Moltino/Moltino/README.md

<h1 align="center">Moltino icon</h1>
<div align="center"><I> Arduino controlled compact modular I/O module </div></I><br>
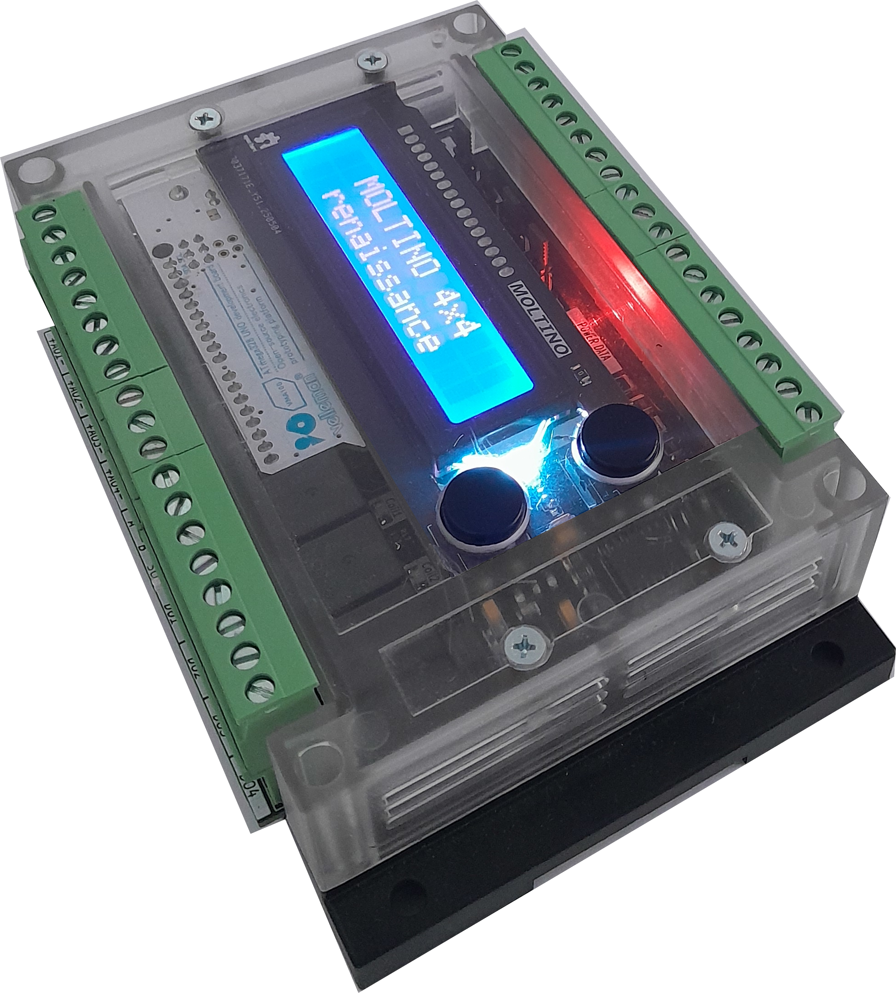
[picture p1: images/IMG_.png]
Moltino 4x4 renaissance

  
<p><b> MOLTINO </b> is a versatile family of modular input/output (I/O) devices designed for measurement, control, and monitoring in industrial, academic, and development environments.
It is a documented hardware platform with publicly available schematics to support firmware creation and system integration.
Users are encouraged to develop their own firmware and applications tailored to specific use cases.
The system is compatible with a wide range of Arduino Uno form factor controllers, including AVR, STM32, ESP32, RP2040, among others, offering flexibility and scalability for different performance needs. These platforms also enable the integration of additional features such as wireless communication (Wi-Fi, Bluetooth), real-time clock (RTC), external storage, or advanced processing capabilities, significantly expanding the development possibilities depending on the project.<br>
<b> MOLTINO </b> is committed to fostering openness and collaboration while ensuring commercial viability and product reliability.</p><hr>
<p><lh><u><b>Main features <b>MOLTINO</b> 4x4 renaissance:</b></u></lh>
<ul><li>4 0-10V/0-20mA analog inputs (16bit resolution)</li>
<li>4 multifunction smart digital inputs</li>
<li>4 0-10V/300mA analog outputs</li>
<li>4 relay outputs</li>
<li>Logic compatible with 5V and 3.3V</li>
<li>Integrated power supply</li>
<li>Integrated RS485 communication</li>
<li>Optional LCD screen</li>
<li>Modular design</li>
<li>Maximum protection</li></ul></p><hr>
<p><b>Flexible firmware development:</b></p>
<p><b> MOLTINO </b> allows anyone to develop their own firmware tailored to specific needs.
Thanks to its compatibility with standard Arduino Uno form factor boards, developers can easily use a wide range of controllers available on the market — including AVR, STM32, ESP32, and RP2040 — to create powerful and customized solutions.</p>
<p><b> Ready-to-Use Firmware:</b></p>
<p>Precompiled firmware versions are also available for download, eliminating the need for firmware development in many cases. These firmwares are personalizable and configurable, can be adapted to various use cases with minimal effort.</p>
