Moltino/Moltino/docs/hardware/portreference_rev7.pdf

## MOLTINO 4x4 renaissance – arduino port reference

Rev.7.
tmslab 2025-05-24
Arduino port | UNO R3 16bit AD
0 | RS485 RX
1 | RS485 TX
2 | RS485 DIR
3 | DI1
4 | DO1
5 | AO1 (PWM)
6 | AO2 (PWM)
7 | DO2
8 | DO3
9 | AO3 (PWM)
10 | AO4 (PWM)
11 | DI2
12 | DI3
13 | DATA LED
(A0) 14 | DI4
(A1) 15 | DO4
(A2) 16 | BUTTON1
(A3) 17 | BUTTON2
(A4) 18 | SDA
(A5) 19 | SCL
