Moltino/Moltino/docs/index.md

# Bienvenido a la documentación de MOLTINO
