Moltino/Moltino/docs/firmware/ES/Mapa_de_registros_Moltino_xxx_v16_ext.xlsx

MAPA DE REGISTROS MODBUS MOLTINO xxx
Ver.:16.2
Última revisión: 15.09.2025
tmslab
READ COILS Código de función: 01
Dirección del registro (dec) | Memoria de almacenamiento | Acción | Descripción | Valor por defecto | Disponibilidad
0 | VOLATILE | RW | Leer el estado de la salida digital 1 (boolean) |  | UNO R3,R4 | M4x4,M2x8
1 | VOLATILE | RW | Leer el estado de la salida digital 2 (boolean) |  | UNO R3,R4 | M4x4,M2x8
2 | VOLATILE | RW | Leer el estado de la salida digital 3 (boolean) |  | UNO R3,R4 | M4x4,M2x8
3 | VOLATILE | RW | Leer el estado de la salida digital 4 (boolean) |  | UNO R3,R4 | M4x4,M2x8
4 | VOLATILE | RW | Leer el estado de la salida digital 5 (boolean) |  | UNO R3,R4 | M2x8
5 | VOLATILE | RW | Leer el estado de la salida digital 6 (boolean) |  | UNO R3,R4 | M2x8
6 | VOLATILE | RW | Leer el estado de la salida digital 7 (boolean) |  | UNO R3,R4 | M2x8
7 | VOLATILE | RW | Leer el estado de la salida digital 8 (boolean) |  | UNO R3,R4 | M2x8
READ DISCRETE INPUTS Código de función: 02
Dirección del registro (dec) | Memoria de almacenamiento | Acción | Descripción |  | Disponibilidad
10000 | VOLATILE | RO | Leer el estado instantaneo de la entrada digital 1 (boolean) |  | UNO R3,R4 | M4x4,M2x8
10001 | VOLATILE | RO | Leer el estado instantaneo de la entrada digital 2 (boolean) |  | UNO R3,R4 | M4x4,M2x8
10002 | VOLATILE | RO | Leer el estado instantaneo de la entrada digital 3 (boolean) |  | UNO R3,R4 | M4x4,M2x8
10003 | VOLATILE | RO | Leer el estado instantaneo de la entrada digital 4 (boolean) |  | UNO R3,R4 | M4x4,M2x8
10004 | VOLATILE | RO | Leer el estado instantaneo de la entrada digital 5 (boolean) |  | UNO R3,R4 | M2x8
10005 | VOLATILE | RO | Leer el estado instantaneo de la entrada digital 6 (boolean) |  | UNO R3,R4 | M2x8
10006 | VOLATILE | RO | Leer el estado instantaneo de la entrada digital 7 (boolean) |  | UNO R3,R4 | M2x8
10007 | VOLATILE | RO | Leer el estado instantaneo de la entrada digital 8 (boolean) |  | UNO R3,R4 | M2x8
10008 | VOLATILE | RO | Leer el estado de la entrada digital latcheada 1 (boolean) |  | UNO R3,R4 | M4x4,M2x8
10009 | VOLATILE | RO | Leer el estado de la entrada digital latcheada 2 (boolean) |  | UNO R3,R4 | M4x4,M2x8
10010 | VOLATILE | RO | Leer el estado de la entrada digital latcheada 3 (boolean) |  | UNO R3,R4 | M4x4,M2x8
10011 | VOLATILE | RO | Leer el estado de la entrada digital latcheada 4 (boolean) |  | UNO R3,R4 | M4x4,M2x8
10012 | VOLATILE | RO | Leer el estado de la entrada digital latcheada 5 (boolean) |  | UNO R3,R4 | M2x8
10013 | VOLATILE | RO | Leer el estado de la entrada digital latcheada 6 (boolean) |  | UNO R3,R4 | M2x8
10014 | VOLATILE | RO | Leer el estado de la entrada digital latcheada 7 (boolean) |  | UNO R3,R4 | M2x8
10015 | VOLATILE | RO | Leer el estado de la entrada digital latcheada 8 (boolean) |  | UNO R3,R4 | M2x8
READ INPUT REGISTERS Código de función: 04
Dirección del registro (dec) | Memoria de almacenamiento | Acción | Descripción |  | Disponibilidad
30000 | VOLATILE | RO | Leer el valor digital de la entrada analog CH1 |  | UNO R3,R4 | M4x4
30001 | VOLATILE | RO | Leer el valor digital de la entrada analog CH2 |  | UNO R3,R4 | M4x4
30002 | VOLATILE | RO | Leer el valor digital de la entrada analog CH3 |  | UNO R3,R4 | M4x4
30003 | VOLATILE | RO | Leer el valor digital de la entrada analog CH4 |  | UNO R3,R4 | M4x4
30004 | VOLATILE | RO | Memoria reservada |  | UNO R3,R4 | Reservada
30005 | VOLATILE | RO | Memoria reservada |  | UNO R3,R4 | Reservada
30006 | VOLATILE | RO | Memoria reservada |  | UNO R3,R4 | Reservada
30007 | VOLATILE | RO | Memoria reservada |  | UNO R3,R4 | Reservada
30008 | VOLATILE | RO | Memoria reservada (temperatura interna) |  | UNO R3,R4 | Reservada
READ HOLDING REGISTERS Código de función: 03
Dirección del registro (dec) | Memoria de almacenamiento | Acción | Descripción |  | Disponibilidad
40000 | VOLATILE | RW | Leer el valor de la salida analog 1 |  | UNO R3,R4 | M4x4,M2x8
40001 | VOLATILE | RW | Leer el valor de la salida analog 2 |  | UNO R3,R4 | M4x4,M2x8
40002 | VOLATILE | RW | Leer el valor de la salida analog 3 |  | UNO R3,R4 | M4x4,M2x8
40003 | VOLATILE | RW | Leer el valor de la salida analog 4 |  | UNO R3,R4 | M4x4,M2x8
40004 | VOLATILE | RW | Memoria reservada |  | UNO R3,R4 | Reservada
40005 | VOLATILE | RW | Memoria reservada |  | UNO R3,R4 | Reservada
40006 | VOLATILE | RW | Memoria reservada |  | UNO R3,R4 | Reservada
40007 | VOLATILE | RW | Memoria reservada |  | UNO R3,R4 | Reservada
40008 | VOLATILE-NO VOLATILE | RO | Leer el contador de eventos 1 ( 32bits, turbo Discrete input 1) |  | UNO R3,R4 | M4x4,M2x8
40009 | VOLATILE-NO VOLATILE | RO | Leer el contador 1/2 (LSB 16bits de 32bits )
40010 | VOLATILE-NO VOLATILE | RO | Leer el contador de eventos 2 ( 32bits, turbo Discrete input 2) |  | UNO R3,R4 | M4x4,M2x8
40011 | VOLATILE-NO VOLATILE | RO | Leer el contador 2/2 ( LSB 16bits de 32bits )
40012 | VOLATILE-NO VOLATILE | RO | Leer el contador de eventos 3 ( 32bits, turbo Discrete input 3) |  | UNO R3,R4 | M4x4,M2x8
40013 | VOLATILE-NO VOLATILE | RO | Leer el contador 3/2 (LSB 16bits de 32bits )
40014 | VOLATILE-NO VOLATILE | RO | Leer el contador de eventos 4 ( 32bits, turbo Discrete input 4) |  | UNO R3,R4 | M4x4,M2x8
40015 | VOLATILE-NO VOLATILE | RO | Leer el contador 4/2 (LSB 16bits de 32bits )
40016 | VOLATILE-NO VOLATILE | RO | Leer el contador de eventos 5 ( 32bits, turbo Discrete input 5) |  | UNO R3,R4 | M2x8
40017 | VOLATILE-NO VOLATILE | RO | Leer el contador 4/2 (LSB 16bits de 32bits )
40018 | VOLATILE-NO VOLATILE | RO | Leer el contador de eventos 6 ( 32bits, turbo Discrete input 6) |  | UNO R3,R4 | M2x8
40019 | VOLATILE-NO VOLATILE | RO | Leer el contador 4/2 (LSB 16bits de 32bits )
40020 | VOLATILE-NO VOLATILE | RO | Leer el contador de eventos 7 ( 32bits, turbo Discrete input 7) |  | UNO R3,R4 | M2x8
40021 | VOLATILE-NO VOLATILE | RO | Leer el contador 4/2 (LSB 16bits de 32bits )
40022 | VOLATILE-NO VOLATILE | RO | Leer el contador de eventos 8 ( 32bits, turbo Discrete input 8) |  | UNO R3,R4 | M2x8
40023 | VOLATILE-NO VOLATILE | RO | Leer el contador 4/2 (LSB 16bits de 32bits )
40024 | VOLATILE | RO | Leer la frecuencia de la entrada digital CH1 ( Hercios ) |  | UNO R3,R4 | M4x4,M2x8
40025 | VOLATILE | RO | Leer la frecuencia de la entrada digital CH2 ( Hercios ) |  | UNO R3,R4 | M4x4,M2x8
40026 | VOLATILE | RO | Leer la frecuencia de la entrada digital CH3 ( Hercios ) |  | UNO R3,R4 | M4x4,M2x8
40027 | VOLATILE | RO | Leer la frecuencia de la entrada digital CH4 ( Hercios ) |  | UNO R3,R4 | M4x4,M2x8
40028 | VOLATILE | RO | Leer la frecuencia de la entrada digital CH5 ( Hercios ) |  | UNO R3,R4 | M2x8
40029 | VOLATILE | RO | Leer la frecuencia de la entrada digital CH6 ( Hercios ) |  | UNO R3,R4 | M2x8
40030 | VOLATILE | RO | Leer la frecuencia de la entrada digital CH7 ( Hercios ) |  | UNO R3,R4 | M2x8
40031 | VOLATILE | RO | Leer la frecuencia de la entrada digital CH8 ( Hercios ) |  | UNO R3,R4 | M2x8
40032 | VOLATILE | RO | Leer el error del bucle de corriente (4-20mA, Boolean / ch) |  | UNO R3,R4 | M4x4
REGION CONFIG
40033 | NO VOLATILE | RW | Leer el número ID de la placa ( Byte L ) | 1 | UNO R3,R4 | M4x4,M2x8
40034 | NO VOLATILE | RW | Leer la velocidad serial ( Byte L ) | 9600bps | UNO R3,R4 | M4x4,M2x8
40035 | NO VOLATILE | RW | Leer la mascara de las entradas digitales ( MASK, Byte L ) | 11111111b | UNO R3,R4 | M4x4,M2x8
40036 | NO VOLATILE | RW | Leer el estado de la memoria de los contadores (on/off, bool) | 0 | UNO R3,R4 | M4x4,M2x8
40037 | NO VOLATILE | RW | Leer la mascara Contar delante / atrás / contador | 4 bitsL 0 → delante todo | UNO R3,R4 | M4x4
40038 | NO VOLATILE | RW | Leer la escala de valor de las entradas analogicas | 32767 | UNO R3,R4 | M4x4
40039 | NO VOLATILE | RW | Reservado | 0 | UNO R3,R4 | M4x4
40040 | NO VOLATILE | RW | 4-20mA error bit / canal | 1111 ( encendido todo ) | UNO R3,R4 | M4x4
40041 | NO VOLATILE | RW | Leer el valor de la resolución de las salidas analogicas | R3: 8bit; R4: 12bit | UNO R3,R4 | M4x4
40042 | NO VOLATILE | RW | Leer el valor de la recalibración de las salidas analogicas | R3: 255; R4: 4095 | UNO R3,R4 | M4x4
40043 | NO VOLATILE | RW | Leer el tipo de medición en LCD (EA, p,V,mA) | points | UNO R3,R4 | M4x4
40044 | NO VOLATILE | RW | Leer el valor del tiempo del rele 1/ bi-monoestable | 0 | UNO R3,R4 | M4x4,M2x8
40045 | NO VOLATILE | RW | Leer el valor del tiempo del rele 2/ bi-monoestable | 0 | UNO R3,R4 | M4x4,M2x8
40046 | NO VOLATILE | RW | Leer el valor del tiempo del rele 3/ bi-monoestable | 0 | UNO R3,R4 | M4x4,M2x8
40047 | NO VOLATILE | RW | Leer el valor del tiempo del rele 4/ bi-monoestable | 0 | UNO R3,R4 | M4x4,M2x8
40048 | NO VOLATILE | RW | Leer el valor del tiempo del rele 5/ bi-monoestable | 0 | UNO R3,R4 | M2x8
40049 | NO VOLATILE | RW | Leer el valor del tiempo del rele 6/ bi-monoestable | 0 | UNO R3,R4 | M2x8
40050 | NO VOLATILE | RW | Leer el valor del tiempo del rele 7/ bi-monoestable | 0 | UNO R3,R4 | M2x8
40051 | NO VOLATILE | RW | Leer el valor del tiempo del rele 8/ bi-monoestable | 0 | UNO R3,R4 | M2x8
40052 | NO VOLATILE | RO | Leer el tipo de shield y arduino |  | UNO R3,R4 | M4x4,M2x8
40053 | NO VOLATILE | RO | Leer la versión de hardwer |  | UNO R3,R4 | M4x4,M2x8
40054 | NO VOLATILE | RO | Leer la versión de software |  | UNO R3,R4 | M4x4,M2x8
40055 | NO VOLATILE | RO | Leer el numero de serie |  | UNO R3,R4 | M4x4,M2x8
WRITE SINGLE COIL Código de función: 05
Dirección del registro (dec) | Memoria de almacenamiento | Acción | Descripción |  | Disponibilidad
0 | VOLATILE | RW | Escribir el estado de la salida digital 1 (boolean) |  | UNO R3,R4 | M4x4,M2x8
1 | VOLATILE | RW | Escribir el estado de la salida digital 2 (boolean) |  | UNO R3,R4 | M4x4,M2x8
2 | VOLATILE | RW | Escribir el estado de la salida digital 3 (boolean) |  | UNO R3,R4 | M4x4,M2x8
3 | VOLATILE | RW | Escribir el estado de la salida digital 4 (boolean) |  | UNO R3,R4 | M4x4,M2x8
4 | VOLATILE | RW | Escribir el estado de la salida digital 5 (boolean) |  | UNO R3,R4 | M2x8
5 | VOLATILE | RW | Escribir el estado de la salida digital 6 (boolean) |  | UNO R3,R4 | M2x8
6 | VOLATILE | RW | Escribir el estado de la salida digital 7 (boolean) |  | UNO R3,R4 | M2x8
7 | VOLATILE | RW | Escribir el estado de la salida digital 8 (boolean) |  | UNO R3,R4 | M2x8
WRITE SINGLE REGISTER Código de función: 06
Dirección del registro (dec) | Memoria de almacenamiento | Acción | Descripción |  | Disponibilidad
40000 | VOLATILE | RW | Escribir el valor de la salida analog CH1 |  | UNO R3,R4 | M4x4
40001 | VOLATILE | RW | Escribir el valor de la salida analog CH2 |  | UNO R3,R4 | M4x4
40002 | VOLATILE | RW | Escribir el valor de la salida analog CH3 |  | UNO R3,R4 | M4x4
40003 | VOLATILE | RW | Escribir el valor de la salida analog CH4 |  | UNO R3,R4 | M4x4
40004 | VOLATILE | RW | Memoria reservada |  | UNO R3,R4 | Reservada
40005 | VOLATILE | RW | Memoria reservada |  | UNO R3,R4 | Reservada
40006 | VOLATILE | RW | Memoria reservada |  | UNO R3,R4 | Reservada
40007 | VOLATILE | RW | Memoria reservada |  | UNO R3,R4 | Reservada
40008 |  | RO |  |  | No disponible para escribir
40009 |  | RO |  |  | No disponible para escribir
40010 |  | RO |  |  | No disponible para escribir
40011 |  | RO |  |  | No disponible para escribir
40012 |  | RO |  |  | No disponible para escribir
40013 |  | RO |  |  | No disponible para escribir
40014 |  | RO |  |  | No disponible para escribir
40015 |  | RO |  |  | No disponible para escribir
40016 |  | RO |  |  | No disponible para escribir
40017 |  | RO |  |  | No disponible para escribir
40018 |  | RO |  |  | No disponible para escribir
40019 |  | RO |  |  | No disponible para escribir
40020 |  | RO |  |  | No disponible para escribir
40021 |  | RO |  |  | No disponible para escribir
40022 |  | RO |  |  | No disponible para escribir
40023 |  | RO |  |  | No disponible para escribir
40024 |  | RO |  |  | No disponible para escribir
40025 |  | RO |  |  | No disponible para escribir
40026 |  | RO |  |  | No disponible para escribir
40027 |  | RO |  |  | No disponible para escribir
40028 |  | RO |  |  | No disponible para escribir
40029 |  | RO |  |  | No disponible para escribir
40030 |  | RO |  |  | No disponible para escribir
40031 |  | RO |  |  | No disponible para escribir
40032 |  | RO |  |  | No disponible para escribir
REGION CONFIG
40033 | NO VOLATILE | RW | Escribir el número ID de la placa ( Byte L ) | 1 | UNO R3,R4 | M4x4,M2x8
40034 | NO VOLATILE | RW | Escribir la velocidad serial ( Byte L ) | 9600bps | UNO R3,R4 | M4x4,M2x8
40035 | NO VOLATILE | RW | Escribir la mascara de las entradas digitales ( Byte L) | 11111111b | UNO R3,R4 | M4x4,M2x8
40036 | NO VOLATILE | RW | Activar / deactivar la memoria de los contadores (bool) | 0 | UNO R3,R4 | M4x4,M2x8
40037 | NO VOLATILE | RW | Mascara de Dirección de conteo (ascendente/descendente) | 4 bitsL 0 → ascendente todo | UNO R3,R4 | M4x4
40038 | NO VOLATILE | RW | Escribir la scala de valor de las entradas analogicas | 32767 | UNO R3,R4 | M4x4
40039 | NO VOLATILE | RW | Reservado | 0 | UNO R3,R4 | M4x4
40040 | NO VOLATILE | RW | 4-20mA error bit / canal | 1111 ( encendido todo ) | UNO R3,R4 | M4x4
40041 | NO VOLATILE | RW | Escribir el valor de resolución de las salidas analogicas | R3: 8bit; R4: 12bit | UNO R3,R4 | M4x4
40042 | NO VOLATILE | RW | Escribir el valor de la recalibración de las salidas analogicas | R3: 255; R4: 4095 | UNO R3,R4 | M4x4
40043 | NO VOLATILE | RW | Escribir el tipo de medición en LCD (EA,p,V,mA) | points | UNO R3,R4 | M4x4
40044 | NO VOLATILE | RW | Escribir el valor del tiempo del rele 1 / bi-monoestable | 0 | UNO R3,R4 | M4x4,M2x8
40045 | NO VOLATILE | RW | Escribir el valor del tiempo del rele 2 / bi-monoestable | 0 | UNO R3,R4 | M4x4,M2x8
40046 | NO VOLATILE | RW | Escribir el valor del tiempo del rele 3 / bi-monoestable | 0 | UNO R3,R4 | M4x4,M2x8
40047 | NO VOLATILE | RW | Escribir el valor del tiempo del rele 4 / bi-monoestable | 0 | UNO R3,R4 | M4x4,M2x8
40048 | NO VOLATILE | RW | Escribir el valor del tiempo del rele 5 / bi-monoestable | 0 | UNO R3,R4 | M2x8
40049 | NO VOLATILE | RW | Escribir el valor del tiempo del rele 6 / bi-monoestable | 0 | UNO R3,R4 | M2x8
40050 | NO VOLATILE | RW | Escribir el valor del tiempo del rele 7 / bi-monoestable | 0 | UNO R3,R4 | M2x8
40051 | NO VOLATILE | RW | Escribir el valor del tiempo del rele 8 / bi-monoestable | 0 | UNO R3,R4 | M2x8
40052 | NO VOLATILE | RO |  |  | No disponible para escribir
40053 | NO VOLATILE | RO |  |  | No disponible para escribir
40054 | NO VOLATILE | RO |  |  | No disponible para escribir
40055 | NO VOLATILE | RO |  |  | No disponible para escribir
WRITE MULTIPLE COILS Código función: 15 (0F HEX)
Dirección del registro (dec) | Memoria de almacenamiento | Acción | Descripción |  | Disponibilidad
0 | VOLATILE | RW | Escribir el estado de la salida digital 1 (bit, boolean) |  | UNO R3,R4 | M4x4,M2x8
1 | VOLATILE | RW | Escribir el estado de la salida digital 2 (bit, boolean) |  | UNO R3,R4 | M4x4,M2x8
2 | VOLATILE | RW | Escribir el estado de la salida digital 3 (bit, boolean) |  | UNO R3,R4 | M4x4,M2x8
3 | VOLATILE | RW | Escribir el estado de la salida digital 4 (bit, boolean) |  | UNO R3,R4 | M4x4,M2x8
4 | VOLATILE | RW | Escribir el estado de la salida digital 5 (bit, boolean) |  | UNO R3,R4 | M2x8
5 | VOLATILE | RW | Escribir el estado de la salida digital 6 (bit, boolean) |  | UNO R3,R4 | M2x8
6 | VOLATILE | RW | Escribir el estado de la salida digital 7 (bit, boolean) |  | UNO R3,R4 | M2x8
7 | VOLATILE | RW | Escribir el estado de la salida digital 8 (bit, boolean) |  | UNO R3,R4 | M2x8
RESET COUNTERS Código función: 65 (41 HEX)
Dirección del comando | Dirección del registro (dec) | Memoria de almacenamiento | Acción | Descripción | Disponibilidad
40008 | 40008 | VOLATILE – NO VOLATILE | W | Resetear el contador de eventos 1 (DI 1) | UNO R3,R4 | M4x4,M2x8
 | 40009 | VOLATILE – NO VOLATILE | W
40010 | 40010 | VOLATILE – NO VOLATILE | W | Resetear el contador de eventos 2 (DI 2) | UNO R3,R4 | M4x4,M2x8
 | 40011 | VOLATILE – NO VOLATILE | W
40012 | 40012 | VOLATILE – NO VOLATILE | W | Resetear el contador de eventos 3 (DI 3) | UNO R3,R4 | M4x4,M2x8
 | 40013 | VOLATILE – NO VOLATILE | W
40014 | 40014 | VOLATILE – NO VOLATILE | W | Resetear el contador de eventos 4 (DI 4) | UNO R3,R4 | M4x4,M2x8
 | 40015 | VOLATILE – NO VOLATILE | W
40016 | 40016 | VOLATILE – NO VOLATILE | W | Resetear el contador de eventos 5 (DI 5) | UNO R3,R4 | M2x8
 | 40017 | VOLATILE – NO VOLATILE | W
40018 | 40018 | VOLATILE – NO VOLATILE | W | Resetear el contador de eventos 6 (DI 6) | UNO R3,R4 | M2x8
 | 40019 | VOLATILE – NO VOLATILE | W
40020 | 40020 | VOLATILE – NO VOLATILE | W | Resetear el contador de eventos 7 (DI 7) | UNO R3,R4 | M2x8
 | 40021 | VOLATILE – NO VOLATILE | W
40022 | 40022 | VOLATILE – NO VOLATILE | W | Resetear el contador de eventos 8 (DI 8) | UNO R3,R4 | M2x8
 | 40023 | VOLATILE – NO VOLATILE | W
