Moltino/Moltino/docs/hardware/schematic_lcdboardrev1.pdf

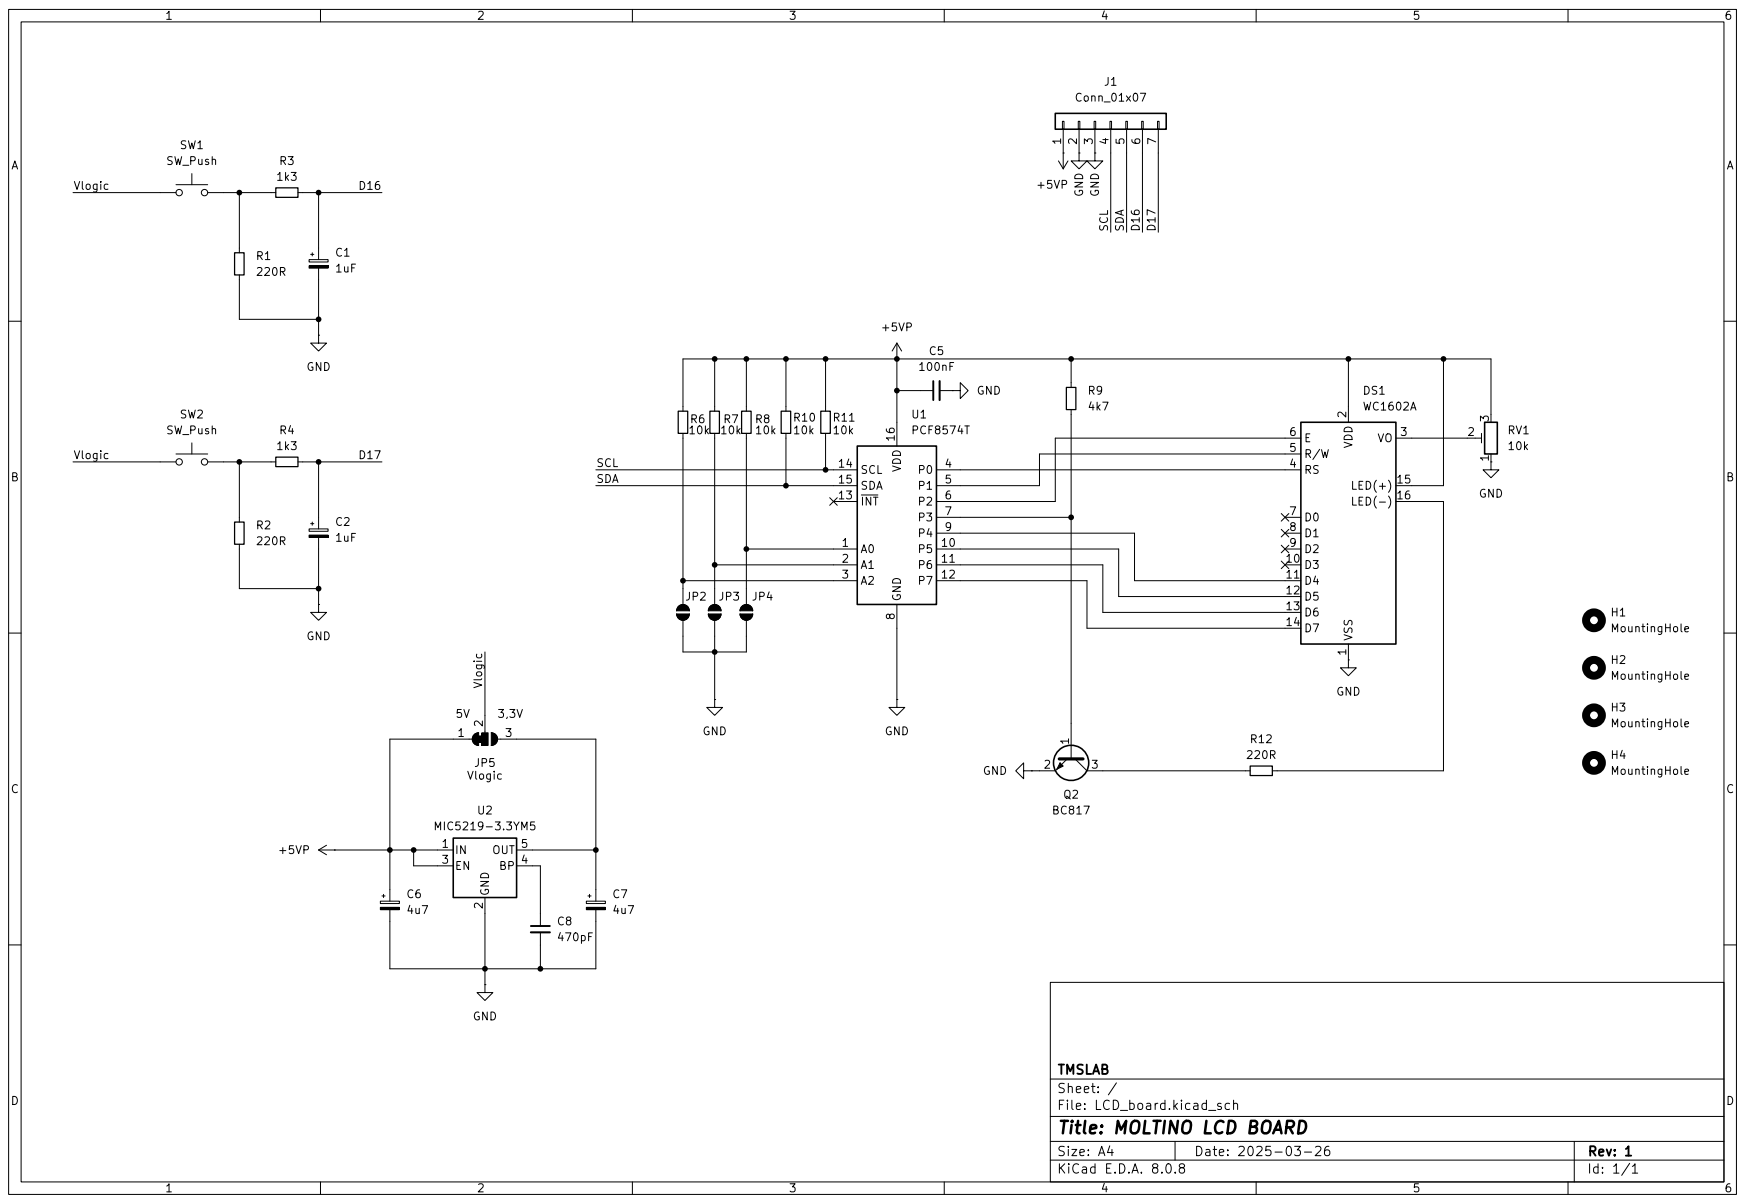
[picture p14: page 1]
