Moltino/Moltino/(commit log)

2025-05-21 Create README.md
    Moltino schematic open hardware
    Moltino Modbus virtual memory map
2025-05-23 Create index.md
    # Bienvenido a la documentación de MOLTINO
2025-05-24 Create Moltino4x4Rev7.pdf
    Moltino4x4 Rev7. schematic
2025-06-12 Add files via upload
    Description of jumpers for mother board
2025-09-10 Añadir librería precompilada y archivos de firmware M4x4_R3
2025-09-10 Añadir archivos .gitkeep para mostrar estructura completa en GitHub
2025-09-26 Añadir archivo nuevo para firmware
2025-09-27 Guardar cambios locales antes de sincronizar
2025-09-27 Sacar la carpeta M4x4_R3 en la raiz
2025-09-27 Mover M4x4_R3 fuera de docs/
2025-09-29 Mapa de registros añadidos
    [Mapa_de_registros_Moltino_xxx_v16_ext.xlsx]
2025-10-05 Subir MoltinoTester para Linux
